salimHarthi/Autonomous-Vehicle-Challenge-AVC-/README.md

# Autonomous-Vehicle-Challenge-AVC-
In this senior design project, we are tasked with designing and building 
a fully autonomous vehicle to navigate the NRC’s obstacle course.
Specifically, the Autonomous Vehicle Challenge (AVC)

For more details please refer to:  
Final technical report_salim.docx
