salimHarthi/Autonomous-Vehicle-Challenge-AVC-/RC_final_version/green-circle-md.png

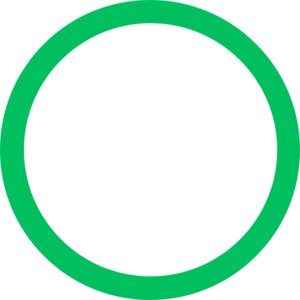
RC_final_version/green-circle-md.png
