salimHarthi/Autonomous-Vehicle-Challenge-AVC-/RC_final_version/old test p.txt

float input_lat[]={ 39.034071,39.033902,39.033962};
float input_lng[]={-94.577701,-94.577711,-94.577542}; 

float heading_degree[]={315,184,60}
